fmaw/multitool/02-hardware/GLITCHING_FMAW.kicad_pcb

## KiCad design 02-hardware/GLITCHING_FMAW.kicad_pcb (2024-10-02)

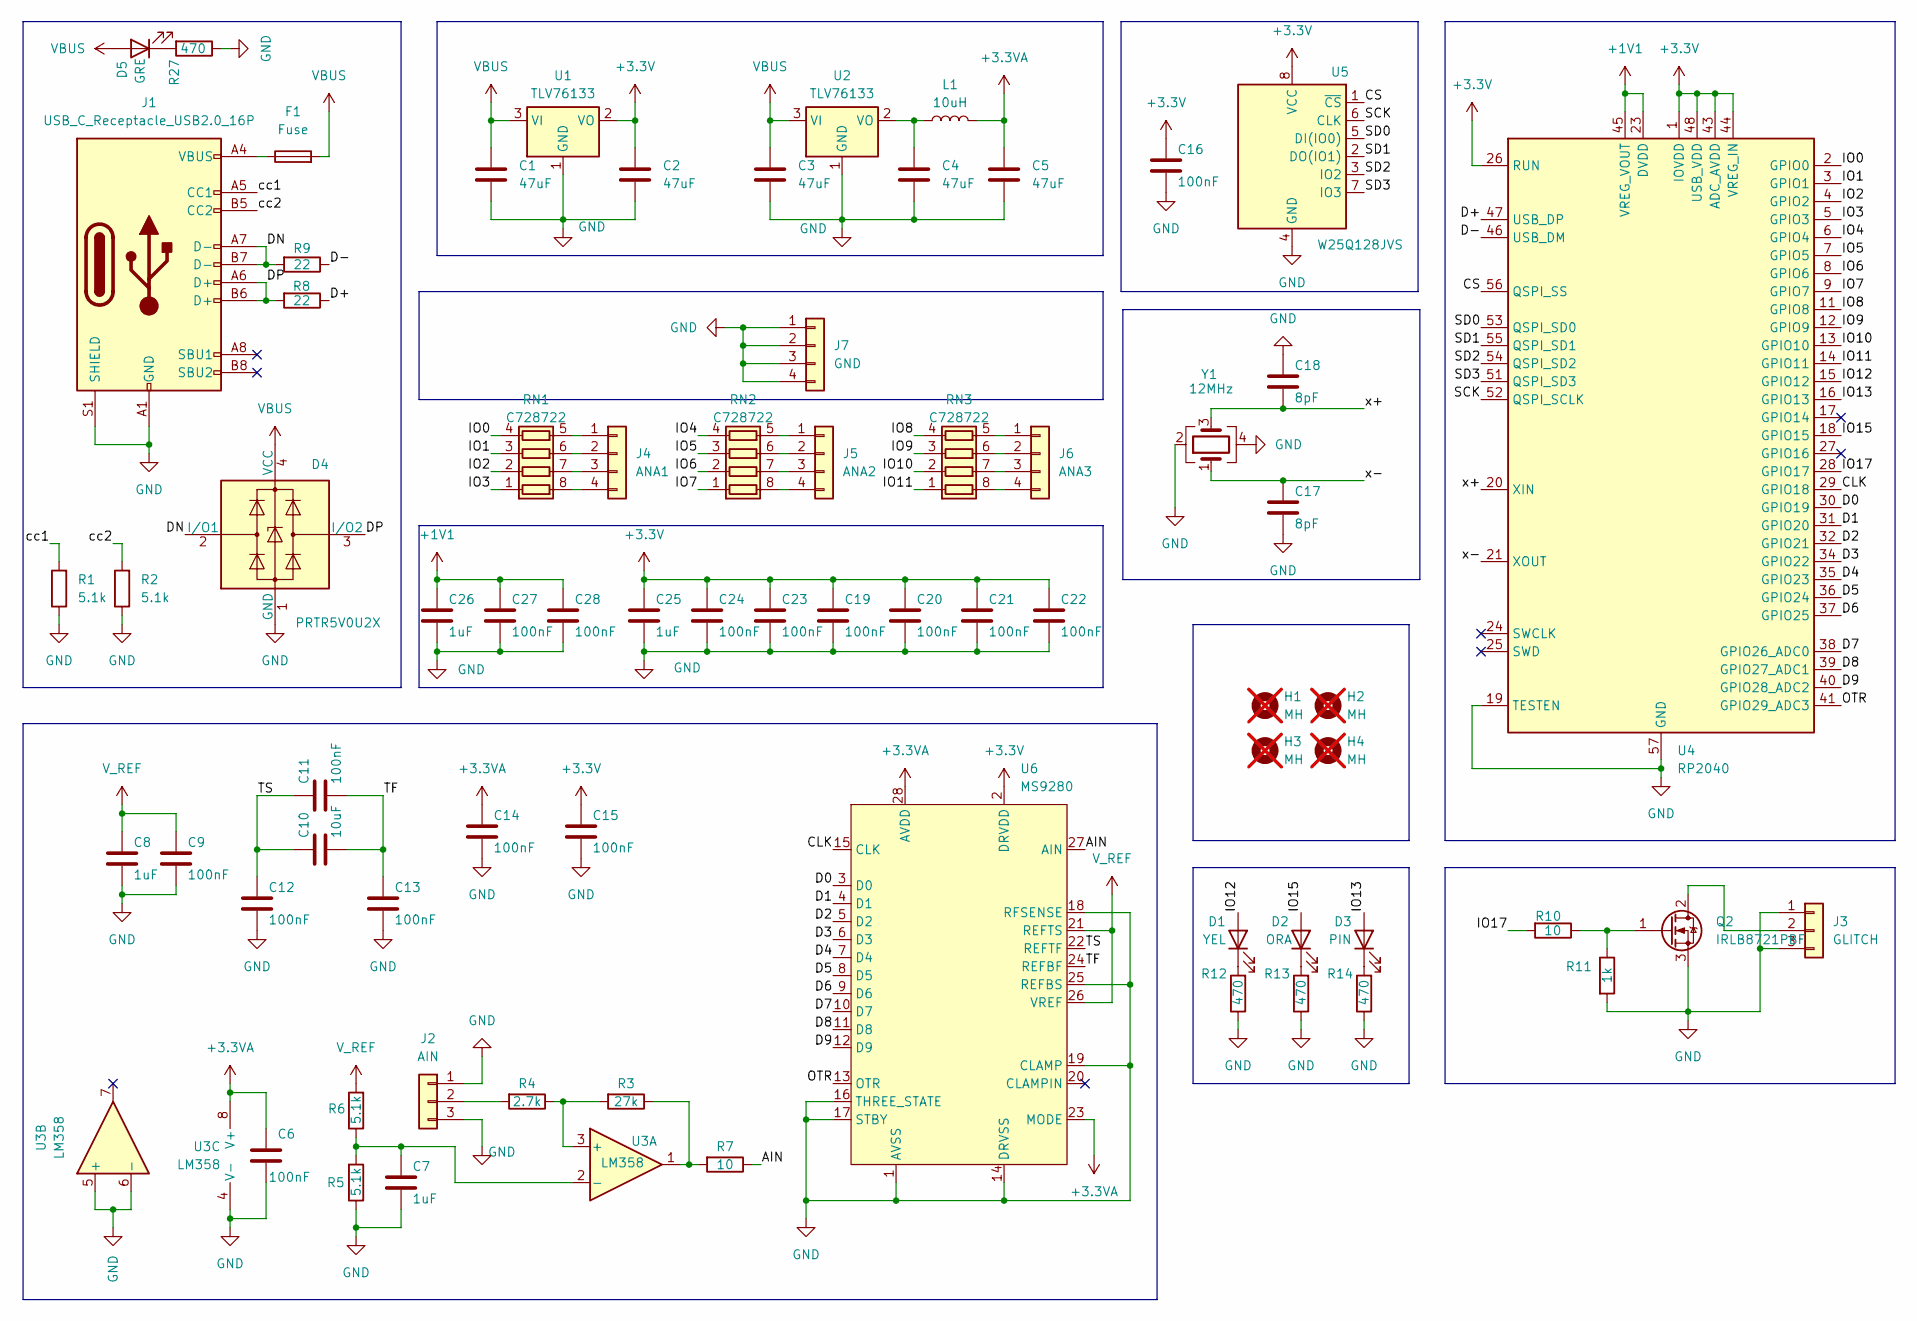
[picture p1: schematic GLITCHING_FMAW.kicad_sch]

Parts:
C1, C2, C3, C4, C5: 47uF; C_1206_3216Metric
C6, C9, C11, C12, C13, C14, C15, C16, C19, C20, C21, C22, C23, C24, C27, C28: 100nF; C_0603_1608Metric
C7, C8, C25, C26: 1uF; C_0603_1608Metric
C10: 10uF; C_0603_1608Metric
C17, C18: 8pF; C_0603_1608Metric
D1: YEL; LED_0603_1608Metric
D2: ORA; LED_0603_1608Metric
D3: PIN; LED_0603_1608Metric
D4: PRTR5V0U2X; SOT-143; LCSC C5180302
D5: GRE; LED_0603_1608Metric
F1: Fuse; Fuse_1812_4532Metric; LCSC C142689
H1, H2, H3, H4: MH; MountingHole_2.2mm_M2_DIN965_Pad; not fitted
J1: USB_C_Receptacle_USB2.0_16P; USB_C_Receptacle_GCT_USB4105-xx-A_16P_TopMnt_Horizontal
J2: AIN; PinHeader_1x03_P2.54mm_Vertical
J3: GLITCH; PinHeader_1x03_P2.54mm_Vertical
J4: ANA1; PinHeader_1x04_P2.54mm_Vertical
J5: ANA2; PinHeader_1x04_P2.54mm_Vertical
J6: ANA3; PinHeader_1x04_P2.54mm_Vertical
J7: GND; PinHeader_1x04_P2.54mm_Vertical
L1: 10uH; L_Bourns_SRP7028A_7.3x6.6mm; LCSC C22463829
Q2: IRLB8721PBF; SOT-223-3_TabPin2; LCSC C73298
R1, R2, R5, R6: 5.1k; R_0603_1608Metric
R3: 27k; R_0603_1608Metric
R4: 2.7k; R_0603_1608Metric
R7, R10: 10; R_0603_1608Metric
R8, R9: 22; R_0603_1608Metric
R11: 1k; R_0603_1608Metric
R12, R13, R14, R27: 470; R_0603_1608Metric
RN1, RN2, RN3: C728722; R_Array_Concave_4x0402; LCSC C728722
U1, U2: TLV76133; SOT-223-3_TabPin2; LCSC C7527500
U3: LM358; SO-8_3.9x4.9mm_P1.27mm; LCSC C693063
U4: RP2040; QFN-56-1EP_7x7mm_P0.4mm_EP3.2x3.2mm
U5: W25Q128JVS; SOIC-8_5.23x5.23mm_P1.27mm; LCSC C97521
U6: MS9280; SSOP-28_5.3x10.2mm_P0.65mm; LCSC C1509021
Y1: 12MHz; Crystal_SMD_Abracon_ABM10-4Pin_2.5x2.0mm; LCSC C1985454

Connections:
+1V1: C26.1, C27.1, C28.1, U4.23 (DVDD), U4.45 (VREG_VOUT), U4.50 (DVDD)
+3.3V: C2.1, C15.1, C16.1, C19.1, C20.1, C21.1, C22.1, C23.1, C24.1, C25.1, U1.2 (VO), U4.1 (IOVDD), U4.10 (IOVDD), U4.22 (IOVDD), U4.26 (RUN), U4.33 (IOVDD), U4.42 (IOVDD), U4.43 (ADC_AVDD), U4.44 (VREG_IN), U4.48 (USB_VDD), U4.49 (IOVDD), U5.8 (VCC), U6.2 (DRVDD)
+3.3VA: C5.1, C6.1, C14.1, L1.2, U3.8 (V+), U6.23 (MODE), U6.28 (AVDD)
/AIN: R7.1, U6.27 (AIN)
/CLK: U4.29 (GPIO18), U6.15 (CLK)
/CS: U4.56 (QSPI_SS), U5.1 (~CS)
/D0: U4.30 (GPIO19), U6.3 (D0)
/D1: U4.31 (GPIO20), U6.4 (D1)
/D2: U4.32 (GPIO21), U6.5 (D2)
/D3: U4.34 (GPIO22), U6.6 (D3)
/D4: U4.35 (GPIO23), U6.7 (D4)
/D5: U4.36 (GPIO24), U6.8 (D5)
/D6: U4.37 (GPIO25), U6.9 (D6)
/D7: U4.38 (GPIO26_ADC0), U6.10 (D7)
/D8: U4.39 (GPIO27_ADC1), U6.11 (D8)
/D9: U4.40 (GPIO28_ADC2), U6.12 (D9)
/D+: R8.1, U4.47 (USB_DP)
/D-: R9.1, U4.46 (USB_DM)
/DN: D4.2 (I/O1), J1.A7 (D-), J1.B7 (D-), R9.2
/DP: D4.3 (I/O2), J1.A6 (D+), J1.B6 (D+), R8.2
/IO0: RN1.4 (R4.1), U4.2 (GPIO0)
/IO1: RN1.3 (R3.1), U4.3 (GPIO1)
/IO2: RN1.2 (R2.1), U4.4 (GPIO2)
/IO3: RN1.1 (R1.1), U4.5 (GPIO3)
/IO4: RN2.4 (R4.1), U4.6 (GPIO4)
/IO5: RN2.3 (R3.1), U4.7 (GPIO5)
/IO6: RN2.2 (R2.1), U4.8 (GPIO6)
/IO7: RN2.1 (R1.1), U4.9 (GPIO7)
/IO8: RN3.4 (R4.1), U4.11 (GPIO8)
/IO9: RN3.3 (R3.1), U4.12 (GPIO9)
/IO10: RN3.2 (R2.1), U4.13 (GPIO10)
/IO11: RN3.1 (R1.1), U4.14 (GPIO11)
/IO12: D1.2 (A), U4.15 (GPIO12)
/IO13: D3.2 (A), U4.16 (GPIO13)
/IO15: D2.2 (A), U4.18 (GPIO15)
/IO17: R10.2, U4.28 (GPIO17)
/OTR: U4.41 (GPIO29_ADC3), U6.13 (OTR)
/SCK: U4.52 (QSPI_SCLK), U5.6 (CLK)
/SD0: U4.53 (QSPI_SD0), U5.5 (DI(IO0))
/SD1: U4.55 (QSPI_SD1), U5.2 (DO(IO1))
/SD2: U4.54 (QSPI_SD2), U5.3 (IO2)
/SD3: U4.51 (QSPI_SD3), U5.7 (IO3)
/TF: C10.2, C11.2, C13.1, U6.24 (REFBF)
/TS: C10.1, C11.1, C12.1, U6.22 (REFTF)
/cc1: J1.A5 (CC1), R1.2
/cc2: J1.B5 (CC2), R2.2
/x+: C18.2, U4.20 (XIN), Y1.3
/x-: C17.1, U4.21 (XOUT), Y1.1
GND: C1.2, C2.2, C3.2, C4.2, C5.2, C6.2, C7.2, C8.2, C9.2, C12.2, C13.2, C14.2, C15.2, C16.2, C17.2, C18.1, C19.2, C20.2, C21.2, C22.2, C23.2, C24.2, C25.2, C26.2, C27.2, C28.2, D4.1 (GND), J1.A1 (GND), J1.A12 (GND), J1.B1 (GND), J1.B12 (GND), J1.S1 (SHIELD), J2.1, J2.3, J3.1, J3.3, J7.1, J7.2, J7.3, J7.4, Q2.3 (S), R1.1, R2.1, R5.1, R11.2, R12.1, R13.1, R14.1, R27.1, U1.1 (GND), U2.1 (GND), U3.4 (V-), U3.5 (+), U3.6 (-), U4.19 (TESTEN), U4.57 (GND), U5.4 (GND), U6.1 (AVSS), U6.14 (DRVSS), U6.16 (THREE_STATE), U6.17 (STBY), U6.18 (RFSENSE), U6.19 (CLAMP), U6.25 (REFBS), Y1.2, Y1.4
unnamed: D1.1 (K), R12.2
unnamed: D2.1 (K), R13.2
unnamed: D3.1 (K), R14.2
unnamed: D5.1 (K), R27.2
unnamed: F1.1, J1.A4 (VBUS), J1.A9 (VBUS), J1.B4 (VBUS), J1.B9 (VBUS)
unnamed: J2.2, R4.2
unnamed: J3.2, Q2.2 (D)
unnamed: J4.1, RN1.5 (R4.2)
unnamed: J4.2, RN1.6 (R3.2)
unnamed: J4.3, RN1.7 (R2.2)
unnamed: J4.4, RN1.8 (R1.2)
unnamed: J5.1, RN2.5 (R4.2)
unnamed: J5.2, RN2.6 (R3.2)
unnamed: J5.3, RN2.7 (R2.2)
unnamed: J5.4, RN2.8 (R1.2)
unnamed: J6.1, RN3.5 (R4.2)
unnamed: J6.2, RN3.6 (R3.2)
unnamed: J6.3, RN3.7 (R2.2)
unnamed: J6.4, RN3.8 (R1.2)
unnamed: Q2.1 (G), R10.1, R11.1
unnamed: R3.1, R7.2, U3.1
unnamed: C4.1, L1.1, U2.2 (VO)
unnamed: R3.2, R4.1, U3.3 (+)
unnamed: C7.1, R5.2, R6.1, U3.2 (-)
VBUS: C1.1, C3.1, D4.4 (VCC), D5.2 (A), F1.2, U1.3 (VI), U2.3 (VI)
V_REF: C8.1, C9.1, R6.2, U6.21 (REFTS), U6.26 (VREF)

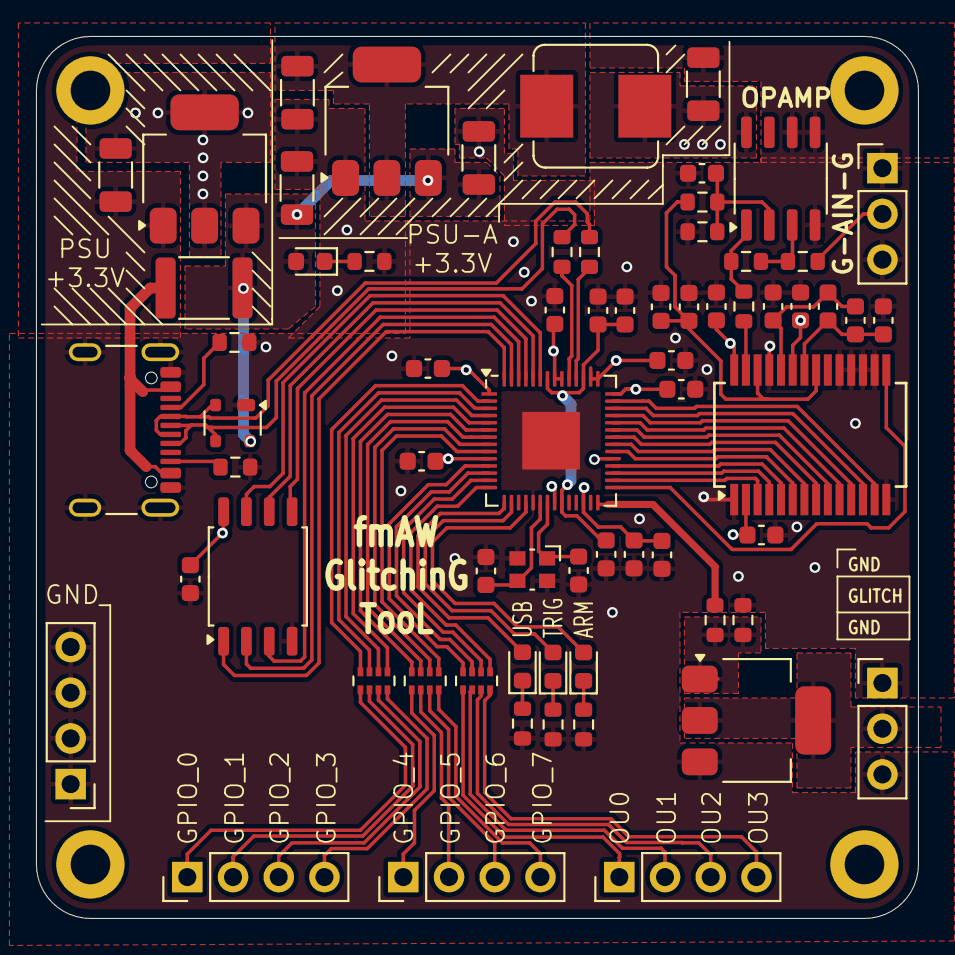
[picture p2: board GLITCHING_FMAW.kicad_pcb from above]

Board: 4 copper layers, 49.0 x 49.0 mm, 72 parts (0 on the bottom side), 75 nets.
